Black-AI-Inc/Dex1-1-r1-adapter/docs/dimensions.pdf

# V2 interface dimensions / mm

Nominal dimensions. Inspect STEP for the full shape; this is not a load qualification.

DEX hole pattern (rotated 90 degrees)

4 x dia. 3.4 clearance holes

X = +/-15; Y = +/-5

M3 x 20 into DEX metal threads

Drawing thread depth: 8

Centre passage: dia. 12

Barrel dia. 49 is not a locating fit

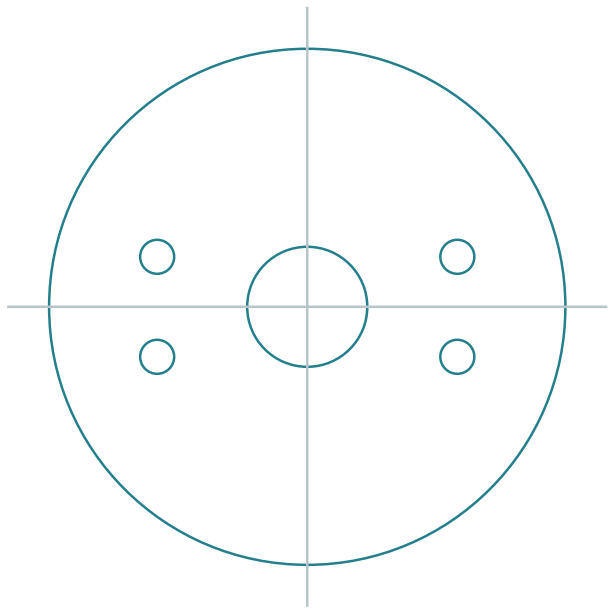
[picture p2: figure]

Neck diameter / flats | 44.5 / 27.6
Rounded retaining ears | dia. 51.5; width 19.6; thickness 1.8
Ear end radius | 0.9
Rear insert depth | 5.0
Anchor front face (unseated) | Z = +14.4
Nominal axial take-up | 0.1
Thrust plate | OD58; thickness 2.4
Collar | 58 across flats; 11.2 high; local tab to Y=-37
Custom printed thread | pitch 4.8; major dia. 51.6; minor dia. 48.4
Thread form | 45 degree flanks; 0.6 crest; not an ISO M thread
Radial fit allowances | C020 = 0.2; C030 = 0.3; C040 = 0.4
Rear screw counterbores | 4 x dia. 8.6; depth 6.4
Gripper screw stack | 13.0 plastic + 0.5 washer; 20 screw
Nominal thread insertion | 6.5; 1.5 remaining drawing depth
Ordinary captive nut | M3; AF5.5 x 2.4; pocket AF5.8

Measure the real wrist and effective blind-hole depth. No manufacturing tolerance has been certified.
