Black-AI-Inc/Dex1-1-r1-adapter/references/dex_official_dimensions.png

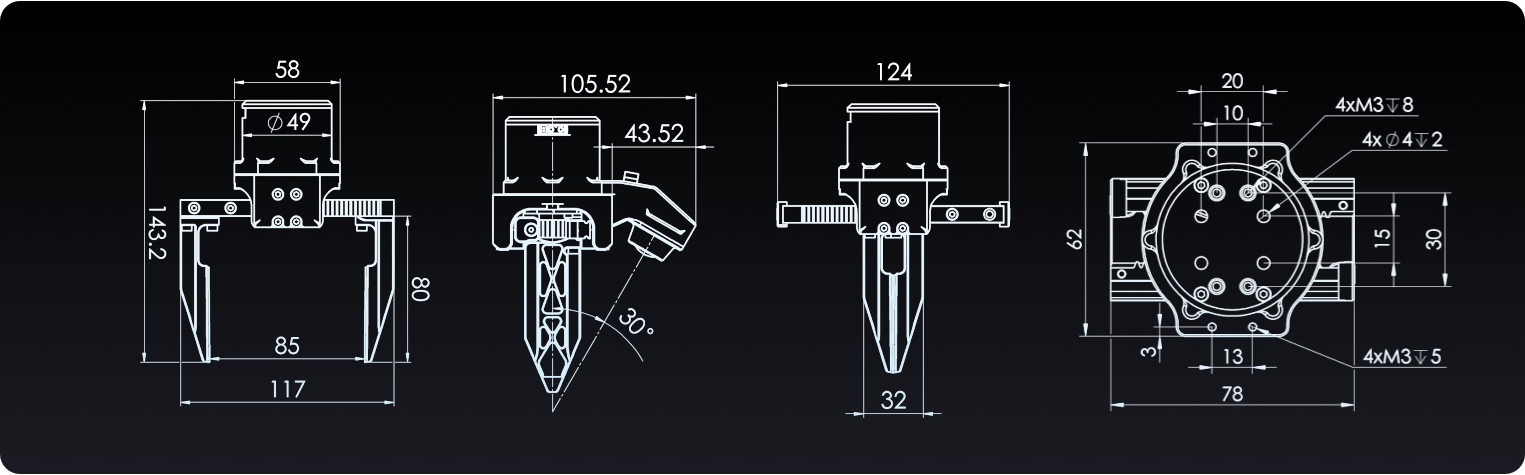
references/dex_official_dimensions.png
