Black-AI-Inc/Dex1-1-r1-adapter/docs/physical_acceptance.csv

test | status | date | printer | ABS_brand_batch | nozzle_mm | layer_mm | XY_compensation | collar_variant | measurement | payload_kg | moment_arm_mm | acceleration | temperature_C | tightening_method | notes
thread_coupon_fit | PENDING
full_length_thread_fit | PENDING
wrist_shell_fit | PENDING
hardware_projection_and_blind_hole_depth | PENDING
thrust_plate_flatness | PENDING
collar_lock_retention | PENDING
axial_reversal_lost_motion | PENDING
torsional_reversal_lost_motion_at_100mm | PENDING
own_weight_30min | PENDING
own_weight_24h_creep | PENDING
task_load_25_percent | PENDING
task_load_50_percent | PENDING
task_load_100_percent | PENDING
low_speed_100_cycles | PENDING
screening_1000_cycles | PENDING
working_temperature_recheck | PENDING
cable_clearance_and_TCP | PENDING
