Black-AI-Inc/Dex1-1-r1-adapter/cad/preview/anchor_assembled.stl

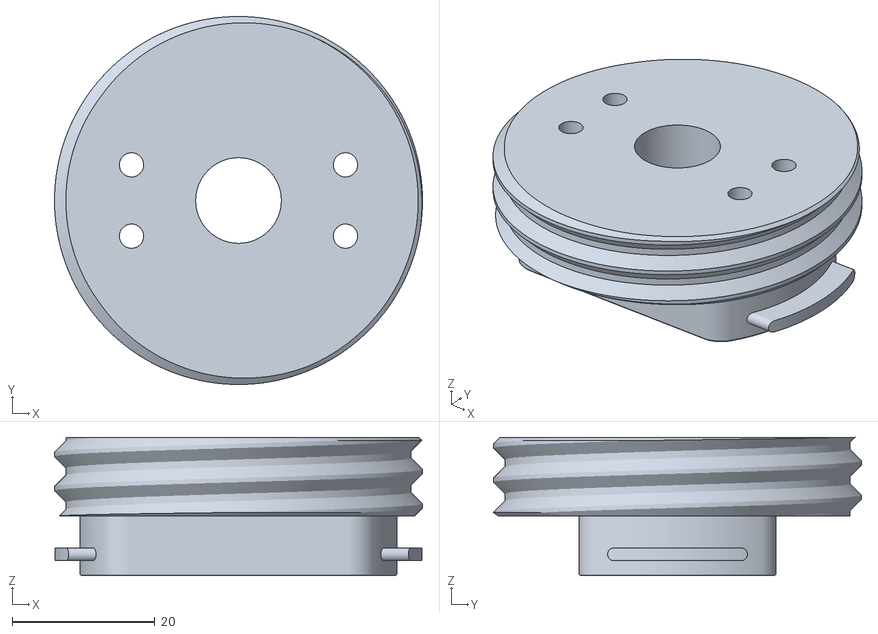
[picture p4: CAD file, 2026-10-19]
cad/preview/anchor_assembled.stl
51.6 x 51.6 x 19.4
