Black-AI-Inc/Dex1-1-r1-adapter/cad/preview/official_wrist_REFERENCE_assembled.stl

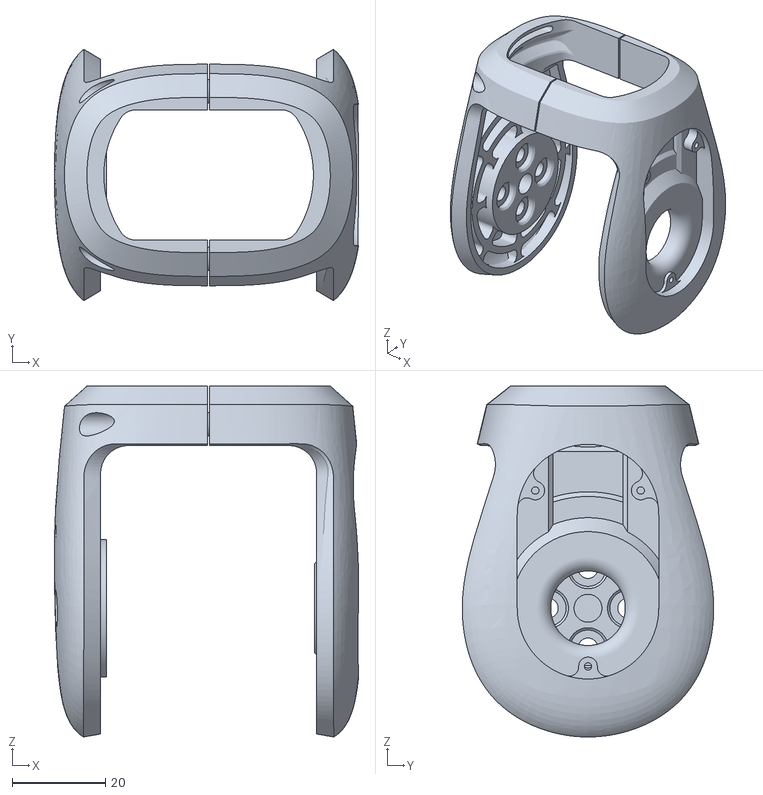
[picture p5: CAD file, 2026-10-19]
cad/preview/official_wrist_REFERENCE_assembled.stl
65.4 x 54.0 x 75.4
