Black-AI-Inc/Dex1-1-r1-adapter/cad/assembly_reference.step

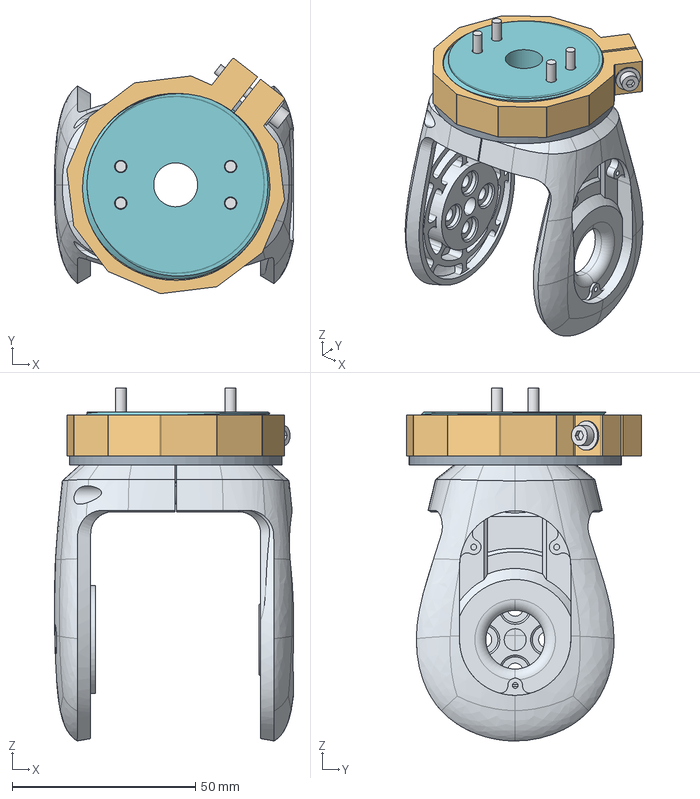
[picture p6: CAD file, 2026-10-19]
cad/assembly_reference.step
65.4 x 64.3 x 96.4 mm
anchor
preload_collar
thrust_plate
official_wrist_REFERENCE
DEX_0_screw
DEX_0_washer
DEX_1_screw
DEX_1_washer
DEX_2_screw
DEX_2_washer
DEX_3_screw
DEX_3_washer
pinch_screw
pinch_washer
M3_nut
