Black-AI-Inc/Dex1-1-r1-adapter/cad/preview/thrust_plate_assembled.stl

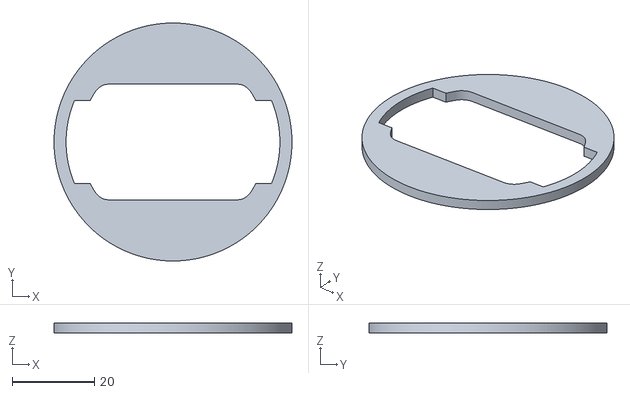
[picture p7: CAD file, 2026-10-19]
cad/preview/thrust_plate_assembled.stl
58.0 x 58.0 x 2.40
