Black-AI-Inc/Dex1-1-r1-adapter/cad/preview/preload_collar_assembled.stl

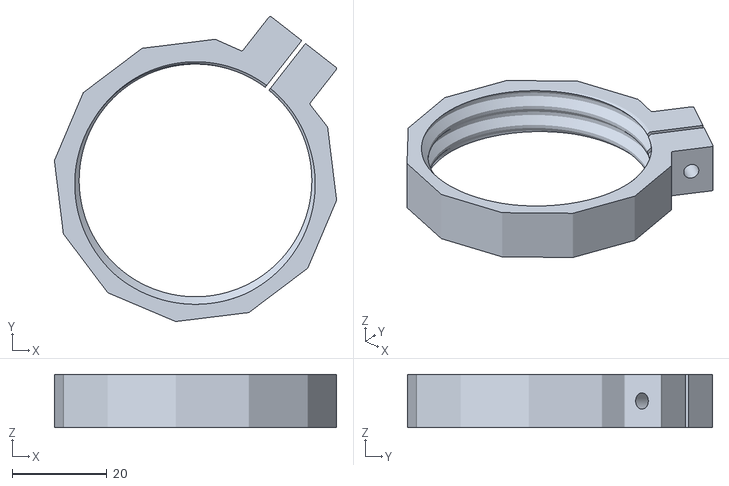
[picture p8: CAD file, 2026-10-19]
cad/preview/preload_collar_assembled.stl
59.4 x 64.3 x 11.2
