Black-AI-Inc/Dex1-1-r1-adapter/cad/dex_mount_holes.dxf

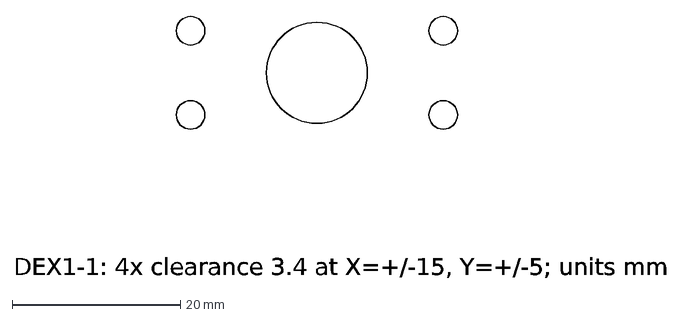
[picture p9: CAD file, 2026-10-19]
cad/dex_mount_holes.dxf
DEX1-1: 4x clearance 3.4 at X=+/-15, Y=+/-5; units mm
