Black-AI-Inc/Dex1-1-r1-adapter/references/g1_dex_meshes/Dex1_finger_link_1.STL

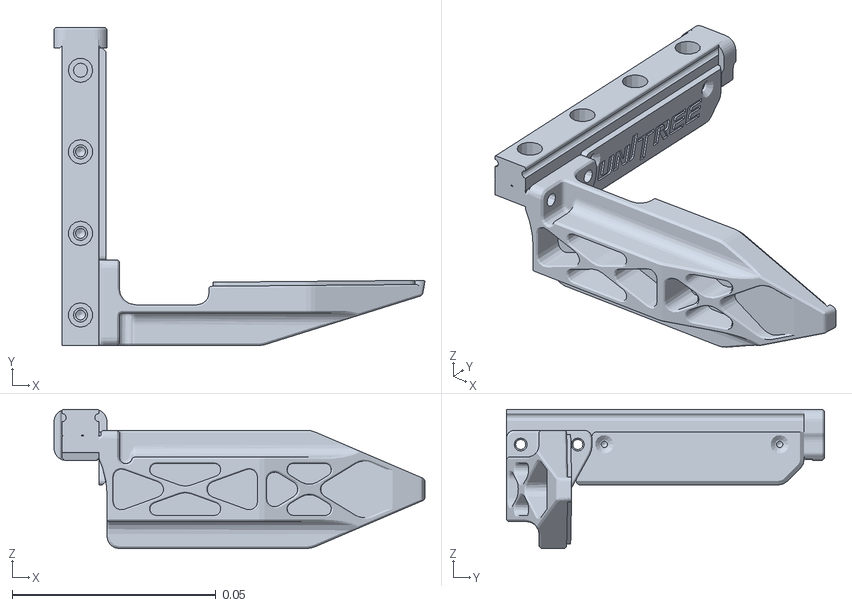
[picture p10: CAD file, 2026-10-19]
references/g1_dex_meshes/Dex1_finger_link_1.STL
0.091 x 0.078 x 0.0341
