Black-AI-Inc/Dex1-1-r1-adapter/cad/thread_male_coupon.step

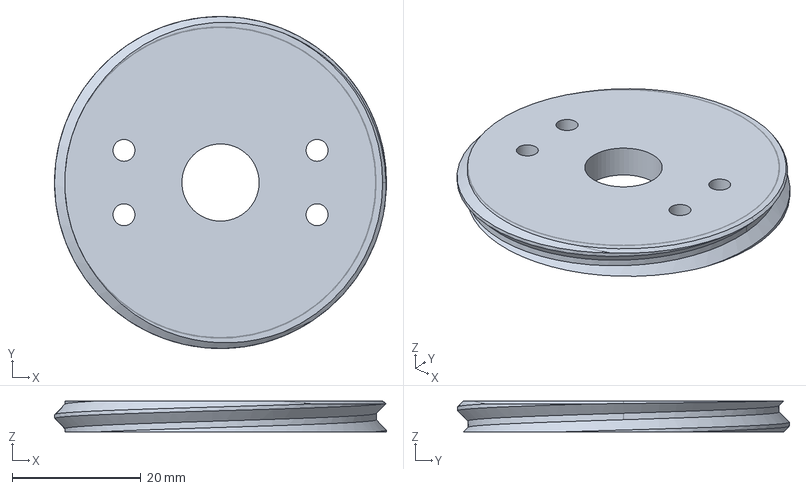
[picture p11: CAD file, 2026-10-19]
cad/thread_male_coupon.step
51.6 x 51.6 x 4.80 mm
