Black-AI-Inc/Dex1-1-r1-adapter/references/g1_dex_meshes/Dex1_base_link.STL

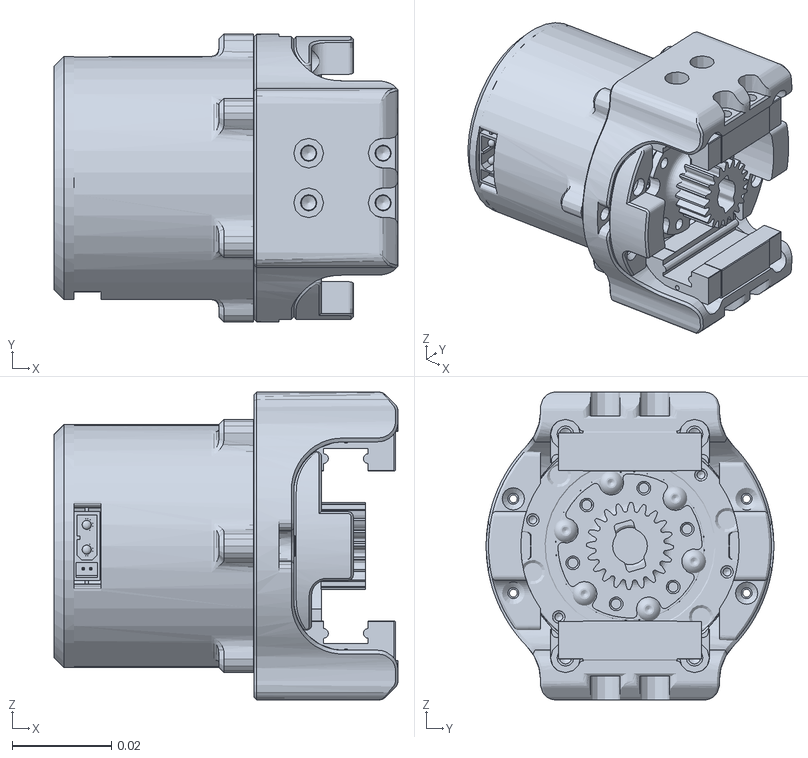
[picture p12: CAD file, 2026-10-19]
references/g1_dex_meshes/Dex1_base_link.STL
0.0693 x 0.058 x 0.062
