Black-AI-Inc/Dex1-1-r1-adapter/references/r1_arm_normalized.stl

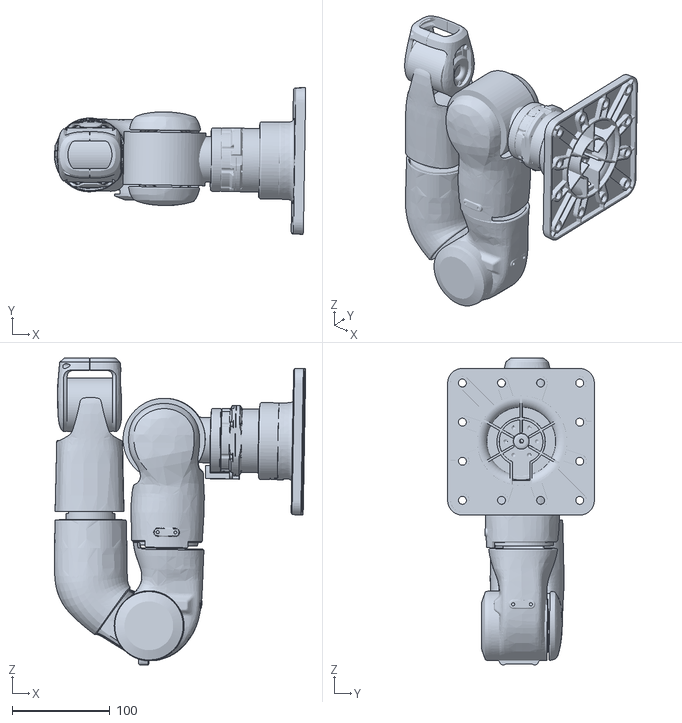
[picture p13: CAD file, 2026-10-19]
references/r1_arm_normalized.stl
257.0 x 150.0 x 314.0
