Black-AI-Inc/Dex1-1-r1-adapter/cad/preload_collar_C040.step

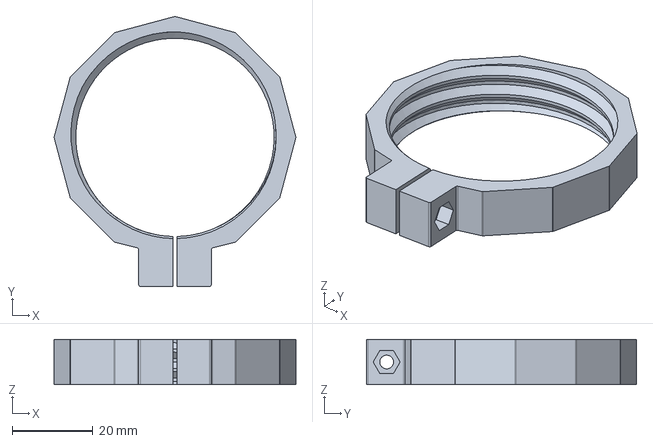
[picture p14: CAD file, 2026-10-19]
cad/preload_collar_C040.step
60.0 x 67.0 x 11.2 mm
