Black-AI-Inc/Dex1-1-r1-adapter/cad/hardware_coupon.step

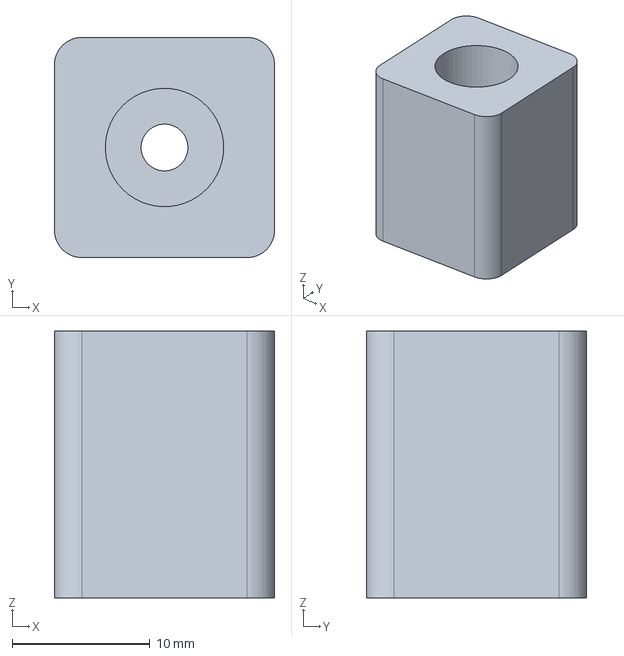
[picture p15: CAD file, 2026-10-19]
cad/hardware_coupon.step
16.0 x 16.0 x 19.4 mm
