Black-AI-Inc/Dex1-1-r1-adapter/cad/wrist_fit_coupon.step

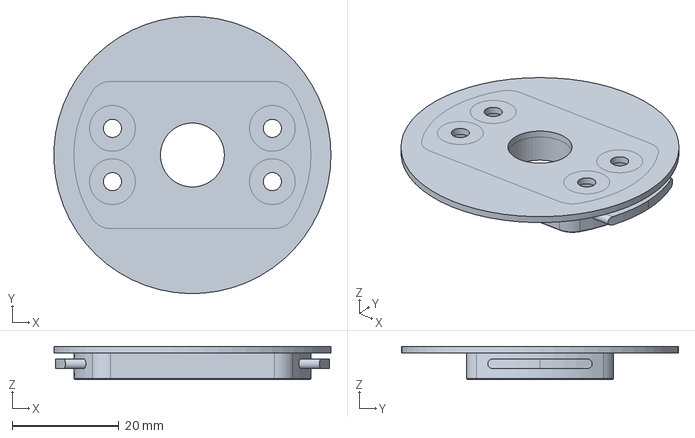
[picture p16: CAD file, 2026-10-19]
cad/wrist_fit_coupon.step
52.0 x 52.0 x 6.28 mm
