Black-AI-Inc/Dex1-1-r1-adapter/(list of files, cad)

Other CAD files:
references/r1_wrist_normalized.step
references/g1_dex_meshes/Dex1_finger_link_2.STL
cad/anchor.step
cad/preload_collar.step
cad/preload_collar_C020.step
cad/thrust_plate.step
cad/preview/DEX_0_screw.stl
cad/preview/DEX_0_washer.stl
cad/preview/DEX_1_screw.stl
cad/preview/DEX_1_washer.stl
cad/preview/DEX_2_screw.stl
cad/preview/DEX_2_washer.stl
cad/preview/DEX_3_screw.stl
cad/preview/DEX_3_washer.stl
cad/preview/M3_nut.stl
cad/preview/pinch_screw.stl
cad/preview/pinch_washer.stl
cad/thread_nut_coupon_C020.step
cad/thread_nut_coupon_C030.step
cad/thread_nut_coupon_C040.step
print/anchor.3mf
print/anchor.stl
print/hardware_coupon.3mf
print/hardware_coupon.stl
print/preload_collar.3mf
print/preload_collar.stl
print/preload_collar_C020.3mf
print/preload_collar_C020.stl
print/preload_collar_C040.3mf
print/preload_collar_C040.stl
print/thread_male_coupon.3mf
print/thread_male_coupon.stl
print/thread_nut_coupon_C020.3mf
print/thread_nut_coupon_C020.stl
print/thread_nut_coupon_C030.3mf
print/thread_nut_coupon_C030.stl
print/thread_nut_coupon_C040.3mf
print/thread_nut_coupon_C040.stl
print/thrust_plate.3mf
print/thrust_plate.stl
print/wrist_fit_coupon.3mf
print/wrist_fit_coupon.stl
references/r1_wrist_normalized.stl
