Black-AI-Inc/Dex1-1-r1-adapter/(commit log)

2026-10-19 Archive v0.2 ABS adapter with CAD, print files and assembly checks
    [ABS_50mm_calibration.stl, DEX_mount_hole_pattern_mm.dxf, Dex1_base_link.STL, Dex1_finger_link_1.STL, Dex1_finger_link_2.STL, adapter_B.step, adapter_B.stl, adapter_B_mm.3mf]
2026-10-19 Add V2 adjustable preload collar and validated print candidates
    [anchor.3mf, anchor.step, anchor.stl, assembly_reference.step, hardware_coupon.3mf, hardware_coupon.step, hardware_coupon.stl, preload_collar.3mf]
2026-10-19 Publish V2 as a standalone project with bilingual documentation and release tooling
    [ABS_50mm_calibration.stl, DEX_0_screw.stl, DEX_0_washer.stl, DEX_1_screw.stl, DEX_1_washer.stl, DEX_2_screw.stl, DEX_2_washer.stl, DEX_3_screw.stl]
